zmz-Max/chaowei/README.md

# 超威战队 · CRTC2026

重庆大学机器人训练大赛（CRTC2026）参赛仓库。

| 项目 | 内容 |
| --- | --- |
| 队伍名称 | 超威战队 |
| 组别 | 新生组（队员均为重庆大学 2026 级本科） |
| 参赛机器人 | 1 号车、2 号车（同构） |
| 中期考核截止 | 2026-10-19 24:00（北京时间） |

## 目录结构

```
.
├── docs/              中期考核文档（提交要求：markdown，全部放在根目录 docs/ 下）
│   ├── README.md      文档索引、写作规范与进度看板
│   ├── 01-电气接线.md  供电链路与信号接线（开发记录）
│   └── assets/        文档插图
├── tools/             辅助脚本（生成文档插图等）
└── firmware/          （待建）机器人嵌入式工程
```

## 队伍分工

> 手册要求技术答辩时提供明确的分工名单。

| 角色 | 队员 | 负责内容 |
| --- | --- | --- |
| 队长 | 周孟子 | 电控（嵌入式程序、接线与控制）、组委会沟通、整体进度统筹 |
| 电控 / 硬件 | 王宏博 | 嵌入式程序、接线与控制 |
| 电控 / 硬件 | 吴锐宇 | 嵌入式程序、接线与控制 |
| 机械 | 辛昊 | 结构设计、装配、3D 打印 |
| 机械 | 何佳俊 | 结构设计、装配、3D 打印 |
| 操作手 | 由队员兼任，赛前确定 | 比赛现场操作机器人 |

## 机器人配置

| 部件 | 型号 / 规格 | 数量（单台） |
| --- | --- | --- |
| 主控 | STM32F103C8T6 核心板 | 1 |
| 电机驱动 | DRV8833 红板（丝印 AIN1/AIN2/BIN1/BIN2/STBY，无独立 VCC 引脚） | 2 |
| 动力 | TT 马达 1:48 单轴 | 4 |
| 轮组 | 60mm 黄色麦克纳姆轮 | 4 |
| 底盘 | 四轮金属折弯底盘 | 1 |
| 舵机 | MG995（180°，金属齿）×2、SG90（180°）×4 | 6 |
| 供电 | 18650 双节电池盒（2S 7.4V）+ 无线继电器 | 1 套 |
| 稳压 | Mini DC-DC 降压模块（7.4V → 5V） | 2 |
| 遥控 | PS2 无线手柄（锁定款）+ XTARK TK-PS2A 接收板 | 1 |

## 进度

- [x] 物资采购
- [x] 仓库搭建、文档框架
- [ ] 供电链路焊接与自检
- [ ] 电机驱动接线 + 4 电机转动
- [ ] PS2 手柄控制底盘运动
- [ ] 舵机接线与可动机构
- [ ] 中期考核材料（视频 + 文档 + 规则测评）
