zmz-Max/chaowei/要粘贴的代码.md

# 要粘贴的代码（PS2 手柄遥控底盘）

> 四个步骤：① 新建 `ps2.h` ② 新建 `ps2.c` ③ 在 `main.c` 里粘 5 段 ④ 在 CMakeLists 里加一行。
> 粘完之后可以让 Codex 读一遍你的文件核对，再编译烧录。

---

## 第一步：新建 `Core/Inc/ps2.h`，把下面全部内容粘进去

```c
/**
 * @file    ps2.h
 * @brief   PS2 无线手柄接收板驱动（STM32F103 + HAL 库）
 *
 * 通信协议：同步串行（SPI Mode 3 等效），LSB first，8 位一帧。
 * 硬件连接：CLK → PA5(SPI1_SCK)、CS → PA4(GPIO)、CMD → PA7(SPI1_MOSI)、
 *           DAT → PA6(SPI1_MISO)、VCC → 3.3V、GND → GND
 */

#ifndef PS2_H
#define PS2_H

#include "main.h"

/* 按键位定义（低字节先收到，合成 16 位后与下面位对应） */
#define PSB_SELECT    0x0001
#define PSB_L3        0x0002
#define PSB_R3        0x0004
#define PSB_START     0x0008
#define PSB_UP        0x0010   /* 十字键上 */
#define PSB_RIGHT     0x0020
#define PSB_DOWN      0x0040
#define PSB_LEFT      0x0080
#define PSB_L2        0x0100
#define PSB_R2        0x0200
#define PSB_L1        0x0400
#define PSB_R1        0x0800
#define PSB_TRIANGLE  0x1000   /* 三角 */
#define PSB_CIRCLE    0x2000   /* 圆圈 */
#define PSB_CROSS     0x4000   /* 叉 */
#define PSB_SQUARE    0x8000   /* 方块 */

typedef struct {
    uint8_t  connected;   /* 1 = 本次通信正常 */
    uint8_t  type;        /* 0x41 数字 / 0x73 模拟 / 0x79 双震动 */
    uint8_t  analog;      /* 1 = 已进入模拟模式（能读摇杆） */
    uint16_t btns;        /* 当前按下的所有键（按位或） */
    uint16_t btns_new;    /* 本次新按下的键 */
    uint8_t  lx, ly;      /* 左摇杆 0~255，中位约 128 */
    uint8_t  rx, ry;      /* 右摇杆 0~255，中位约 128 */
} PS2_t;

uint8_t PS2_Init(SPI_HandleTypeDef *hspi, GPIO_TypeDef *cs_port, uint16_t cs_pin);
void    PS2_Read(PS2_t *ps2);

#endif /* PS2_H */
```

---

## 第二步：新建 `Core/Src/ps2.c`，把下面全部内容粘进去

```c
/**
 * @file    ps2.c
 * @brief   PS2 无线手柄接收板驱动实现
 */

#include "ps2.h"

static SPI_HandleTypeDef *s_hspi;
static GPIO_TypeDef      *s_cs_port;
static uint16_t           s_cs_pin;
static uint16_t           s_prev_btns;

#define CS_LOW()   HAL_GPIO_WritePin(s_cs_port, s_cs_pin, GPIO_PIN_RESET)
#define CS_HIGH()  HAL_GPIO_WritePin(s_cs_port, s_cs_pin, GPIO_PIN_SET)

/* 直接读写寄存器收发 1 字节。
   不用 HAL_SPI_TransmitReceive(…, 1)：F1 的 HAL 在单字节收发时存在
   读完 RXNE 前数据未就绪的问题，直接用寄存器最稳。 */
static uint8_t ps2_xfer(uint8_t tx)
{
    uint32_t guard = 100000;

    while (((s_hspi->Instance->SR & SPI_SR_TXE) == 0) && (--guard != 0)) { }
    *(volatile uint8_t *)&s_hspi->Instance->DR = tx;

    guard = 100000;
    while (((s_hspi->Instance->SR & SPI_SR_RXNE) == 0) && (--guard != 0)) { }

    return *(volatile uint8_t *)&s_hspi->Instance->DR;
}

/* 空转延时：-O0 编译下每轮约 8~12 个周期，200 轮约 25us 左右 */
static void ps2_delay_loops(uint32_t n)
{
    for (volatile uint32_t i = 0; i < n; i++) {
        __NOP();
    }
}

/* 一次完整通信：拉低片选 → 逐字节收发 → 拉高片选 → 间隔
 *
 * 时序要点（PS2 协议对时间敏感，太快接收板会来不及应答）：
 * 1. 片选拉低后要等一会儿再发第一个时钟；
 * 2. 字节之间也要留间隔，无线接收板才有时间准备下一字节；
 * 3. 两次通信之间至少间隔 1~2ms。
 */
static void ps2_transact(const uint8_t *tx, uint8_t *rx, uint8_t len)
{
    CS_LOW();
    ps2_delay_loops(200);

    for (uint8_t i = 0; i < len; i++) {
        rx[i] = ps2_xfer(tx[i]);
        ps2_delay_loops(100);
    }

    CS_HIGH();
    ps2_delay_loops(100);
    HAL_Delay(2);
}

/* 判断应答是否有效：收到合法 ID 字节，或收到固定应答字节 0x5A，都算通信正常 */
static uint8_t ps2_reply_valid(const uint8_t *rx)
{
    if (rx[1] == 0x41 || rx[1] == 0x73 || rx[1] == 0x79) {
        return 1;
    }
    if (rx[2] == 0x5A) {
        return 1;
    }
    return 0;
}

uint8_t PS2_Init(SPI_HandleTypeDef *hspi, GPIO_TypeDef *cs_port, uint16_t cs_pin)
{
    uint8_t rx[9];
    GPIO_InitTypeDef gpio = { 0 };

    s_hspi    = hspi;
    s_cs_port = cs_port;
    s_cs_pin  = cs_pin;

    /* 关键：F1 的 HAL_SPI_Init() 只配置外设，不会把 SPI 使能（SPE 仍为 0）。
       本驱动是直接读写寄存器的，必须自己打开 SPI，否则写进 DR 也不会产生
       时钟，读 RXNE 会一直等不到（表现为程序卡死、LED 不闪）。 */
    __HAL_SPI_ENABLE(hspi);

    /* 给 MISO 线（本设计中为 SPI1 的 PA6，接接收板 DAT）打开内部上拉。
       部分 PS2 接收板的 DAT 是开漏输出，没有上拉时永远读不到高电平，
       现象就是"发得出去、收不回来"，LED 一直闪。这一步不需要加电阻。 */
    gpio.Pin  = GPIO_PIN_6;
    gpio.Mode = GPIO_MODE_INPUT;
    gpio.Pull = GPIO_PULLUP;
    HAL_GPIO_Init(GPIOA, &gpio);

    CS_HIGH();
    HAL_Delay(20);

    /* ① 进入配置模式 */
    {
        const uint8_t tx[9] = { 0x01, 0x43, 0x00, 0x01, 0x00, 0x00, 0x00, 0x00, 0x00 };
        ps2_transact(tx, rx, 9);
    }
    /* ② 打开模拟模式 */
    {
        const uint8_t tx[9] = { 0x01, 0x44, 0x00, 0x01, 0x00, 0x00, 0x00, 0x00, 0x00 };
        ps2_transact(tx, rx, 9);
    }
    /* ③ 设置模式：模拟、双摇杆 */
    {
        const uint8_t tx[9] = { 0x01, 0x4F, 0x00, 0xFF, 0xFF, 0x03, 0x00, 0x00, 0x00 };
        ps2_transact(tx, rx, 9);
    }
    /* ④ 退出配置模式 */
    {
        const uint8_t tx[9] = { 0x01, 0x43, 0x00, 0x00, 0x5A, 0x5A, 0x5A, 0x5A, 0x5A };
        ps2_transact(tx, rx, 9);
    }
    /* ⑤ 反复尝试读取：无线接收板第一次应答可能较慢，给它几次机会 */
    s_prev_btns = 0;
    for (uint8_t attempt = 0; attempt < 5; attempt++) {
        const uint8_t tx[9] = { 0x01, 0x42, 0x00, 0x00, 0x00, 0x00, 0x00, 0x00, 0x00 };
        ps2_transact(tx, rx, 9);
        if (ps2_reply_valid(rx)) {
            return 1;
        }
        HAL_Delay(100);
    }
    return 0;
}

void PS2_Read(PS2_t *ps2)
{
    const uint8_t tx[9] = { 0x01, 0x42, 0x00, 0x00, 0x00, 0x00, 0x00, 0x00, 0x00 };
    uint8_t rx[9] = { 0 };

    ps2_transact(tx, rx, 9);

    ps2->type      = rx[1];
    ps2->connected = ps2_reply_valid(rx) ? 1 : 0;
    ps2->analog    = (rx[1] == 0x73 || rx[1] == 0x79) ? 1 : 0;

    if (ps2->connected) {
        uint16_t now  = (uint16_t)(((uint16_t)rx[4] << 8) | rx[3]);
        ps2->btns_new = (uint16_t)(now & (uint16_t)~s_prev_btns);
        ps2->btns     = now;
        s_prev_btns   = now;

        if (ps2->analog) {
            ps2->rx = rx[5];
            ps2->ry = rx[6];
            ps2->lx = rx[7];
            ps2->ly = rx[8];
        }
    } else {
        /* 通信中断：清空状态，避免拿着旧数据继续开车 */
        ps2->btns     = 0;
        ps2->btns_new = 0;
        ps2->analog   = 0;
        s_prev_btns   = 0;
    }
}
```

---

## 第三步：在 `Core/Src/main.c` 里粘 5 段代码

> 每一段都要粘在对应标记行的**下面**（也就是 `USER CODE BEGIN xxx` 和 `USER CODE END xxx` 之间），
> 这样以后 CubeMX 重新生成代码不会把我们的代码冲掉。

### 3-1 粘到 `/* USER CODE BEGIN Includes */` 下面

```c
#include "ps2.h"
```

### 3-2 粘到 `/* USER CODE BEGIN PD */` 下面

```c
#define DUTY_FWD   60      /* 前进 / 后退速度，可改 40~80 */
#define DUTY_TURN  55      /* 原地转向速度 */
```

### 3-3 粘到 `/* USER CODE BEGIN PV */` 下面

```c
static PS2_t ps2;

/* 单个电机：duty -100 ~ +100，负数反转，0 停转 */
static void Motor_Set(uint32_t ch, uint16_t dir_pin, int duty)
{
  const uint32_t arr1 = 50;                 /* ARR(49) + 1 */

  if (duty >  100) duty =  100;
  if (duty < -100) duty = -100;

  if (duty >= 0) {
    HAL_GPIO_WritePin(GPIOB, dir_pin, GPIO_PIN_RESET);   /* 方向脚 = 0 → 正转 */
    __HAL_TIM_SET_COMPARE(&htim2, ch, arr1 * (uint32_t)duty / 100);
  } else {
    HAL_GPIO_WritePin(GPIOB, dir_pin, GPIO_PIN_SET);     /* 方向脚 = 1 → 反转 */
    __HAL_TIM_SET_COMPARE(&htim2, ch, arr1 * (uint32_t)(100 + duty) / 100);
  }
}

/* 底盘：按 左前、左后、右前、右后 四个轮子给速度 */
static void Car_Set(int fl, int rl, int fr, int rr)
{
  Motor_Set(TIM_CHANNEL_1, GPIO_PIN_12, fl);
  Motor_Set(TIM_CHANNEL_2, GPIO_PIN_13, rl);
  Motor_Set(TIM_CHANNEL_3, GPIO_PIN_14, fr);
  Motor_Set(TIM_CHANNEL_4, GPIO_PIN_15, rr);
}
```

### 3-4 粘到 `/* USER CODE BEGIN 2 */` 下面（所有 `MX_xxx_Init()` 之后）

```c
  HAL_TIM_PWM_Start(&htim2, TIM_CHANNEL_1);
  HAL_TIM_PWM_Start(&htim2, TIM_CHANNEL_2);
  HAL_TIM_PWM_Start(&htim2, TIM_CHANNEL_3);
  HAL_TIM_PWM_Start(&htim2, TIM_CHANNEL_4);
  Car_Set(0, 0, 0, 0);

  HAL_GPIO_WritePin(GPIOC, GPIO_PIN_13, GPIO_PIN_SET);   /* 先熄灯，便于区分后面两种状态 */

  if (PS2_Init(&hspi1, GPIOA, GPIO_PIN_4)) {
    HAL_GPIO_WritePin(GPIOC, GPIO_PIN_13, GPIO_PIN_RESET);   /* LED 常亮 = 手柄通信成功 */
  } else {
    /* 通信失败：LED 快闪并停在这里，方便排查接线 */
    while (1) {
      HAL_GPIO_TogglePin(GPIOC, GPIO_PIN_13);
      HAL_Delay(100);
    }
  }

  /* ================= 通道标定（临时调试，查完可删） =================
     上电后自动跑一遍，用来核对“定时器通道 ↔ 实际哪个轮子”的对应关系：
       第 1 段：全部停 3 秒 —— 此时四个轮子必须完全静止；
       第 2~5 段：每段只驱动一个通道（正转 40%），持续 2 秒，
                 该段开始前 LED 会闪 N 下（闪 1 下 = M1，2 下 = M2……）。 */
  Car_Set(0, 0, 0, 0);
  HAL_Delay(3000);

  for (int m = 0; m < 4; m++) {
    Car_Set(0, 0, 0, 0);
    HAL_Delay(300);

    for (int k = 0; k <= m; k++) {
      HAL_GPIO_WritePin(GPIOC, GPIO_PIN_13, GPIO_PIN_RESET);
      HAL_Delay(150);
      HAL_GPIO_WritePin(GPIOC, GPIO_PIN_13, GPIO_PIN_SET);
      HAL_Delay(150);
    }
    HAL_Delay(600);

    switch (m) {
      case 0: Motor_Set(TIM_CHANNEL_1, GPIO_PIN_12, 40); break;
      case 1: Motor_Set(TIM_CHANNEL_2, GPIO_PIN_13, 40); break;
      case 2: Motor_Set(TIM_CHANNEL_3, GPIO_PIN_14, 40); break;
      case 3: Motor_Set(TIM_CHANNEL_4, GPIO_PIN_15, 40); break;
      default: break;
    }
    HAL_Delay(2000);
  }

  Car_Set(0, 0, 0, 0);
  HAL_Delay(1000);
```

### 3-5 粘到 `/* USER CODE BEGIN 3 */` 下面（在 `while (1)` 循环体里）

```c
    PS2_Read(&ps2);

    if (!ps2.connected) {
      Car_Set(0, 0, 0, 0);                                   /* 通信中断立刻停车 */
      HAL_GPIO_WritePin(GPIOC, GPIO_PIN_13, GPIO_PIN_SET);   /* LED 灭 */
    } else {
      HAL_GPIO_WritePin(GPIOC, GPIO_PIN_13, GPIO_PIN_RESET); /* LED 常亮 */

      if (ps2.btns & PSB_UP) {                               /* 十字键上：前进 */
        Car_Set(DUTY_FWD, DUTY_FWD, DUTY_FWD, DUTY_FWD);
      } else if (ps2.btns & PSB_DOWN) {                      /* 十字键下：后退 */
        Car_Set(-DUTY_FWD, -DUTY_FWD, -DUTY_FWD, -DUTY_FWD);
      } else if (ps2.btns & PSB_LEFT) {                      /* 十字键左：原地左转 */
        Car_Set(-DUTY_TURN, -DUTY_TURN, DUTY_TURN, DUTY_TURN);
      } else if (ps2.btns & PSB_RIGHT) {                     /* 十字键右：原地右转 */
        Car_Set(DUTY_TURN, DUTY_TURN, -DUTY_TURN, -DUTY_TURN);
      } else if (ps2.btns & PSB_CROSS) {                     /* 叉键：横移 */
        Car_Set(-DUTY_FWD, DUTY_FWD, DUTY_FWD, -DUTY_FWD);
      } else {
        Car_Set(0, 0, 0, 0);                                 /* 松手即停（滑行） */
      }

      /* 临时调试：按住任意键时熄灭 LED —— 不接电机也能确认按键被读到 */
      if (ps2.btns != 0) {
        HAL_GPIO_WritePin(GPIOC, GPIO_PIN_13, GPIO_PIN_SET);
      }
    }

    HAL_Delay(10);                                           /* 轮询周期约 10ms */
```

---

## 第四步：在 `cmake/stm32cubemx/CMakeLists.txt` 里加一行

找到 `MX_Application_Src` 那个列表里的一行：

```cmake
    ${CMAKE_CURRENT_SOURCE_DIR}/../../Core/Src/main.c
```

在它**下面**加一行：

```cmake
    ${CMAKE_CURRENT_SOURCE_DIR}/../../Core/Src/ps2.c
```

> 不加这一行，编译会报 `undefined reference to 'PS2_Init'`。
> 每次在 CubeMX 里重新生成代码，这个文件都会被重写，**这一行都要重新加一次**。

---

## 粘完之后

告诉 Codex 一声，让他读一遍你的三个文件核对一遍（比人眼快），然后再编译、烧录。
