zmz-Max/chaowei/docs/assets/incident_bare_joint.png

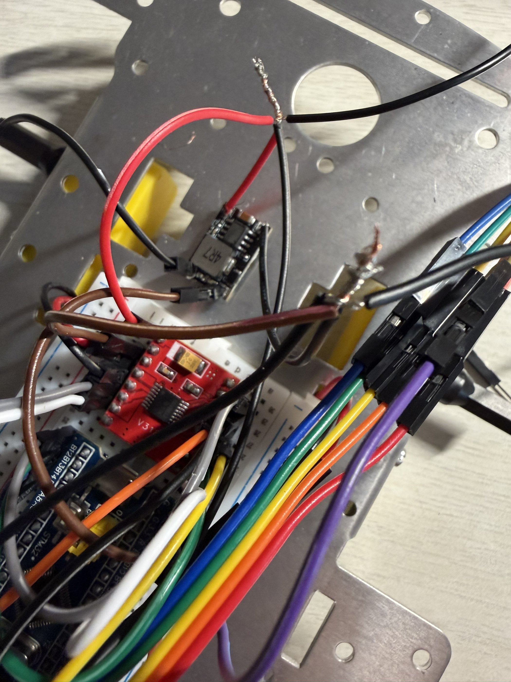
docs/assets/incident_bare_joint.png
