zmz-Max/chaowei/(commit log)

2026-10-12 docs: 建立仓库结构，加入电气接线文档与 DRV8833 实物接线说明
2026-10-12 chore: 忽略本地临时截图文件
2026-10-12 docs: 填写队伍分工名单
2026-10-12 docs: 补充实物接口识别（继电器端子、降压模块、主控）与接线标注图
2026-10-12 docs: 新增电气自检记录表，记录电池盒串联确认结果
2026-10-12 docs: 电源链路自检通过，记录遥控模块点动模式问题
2026-10-13 docs: 补录电源自检实测值，新增 ST-Link 接线与 PS2 接收板实物丝印对应
2026-10-13 docs: 新增定时器与引脚配置表、电机调试步骤
2026-10-13 feat: 新增四路电机测试程序（HAL 与 Arduino 两版）及固件说明
2026-10-13 feat: 新增 PS2 手柄驱动与遥控底盘测试程序，记录降压模块损坏的临时方案
2026-10-14 feat: 集成 PS2 手柄遥控代码到 AIcar 工程并验证编译通过，更新自检记录
2026-10-14 docs: 新增固件工程与调试环境文档，记录 CLion 双配置污染问题
2026-10-14 docs: 记录电源回路短路烧线事故、继电器损坏与整改措施
2026-10-14 docs: 事故照片归档到 assets 并在文档中引用
2026-10-14 docs: 补充短路事故的现场证据与接线工艺整改要求
2026-10-14 chore: 根目录散图不入库，仅保留 docs/assets 下的归档素材
2026-10-14 docs: 新增固件烧录方式与连接失败排查记录（含 flash.cmd）
2026-10-14 feat: 新增一键烧录脚本（根目录 烧录固件.cmd 与 AIcar/flash.cmd）
2026-10-14 fix: 烧录脚本改为 GBK+CRLF 编码，关键命令改为纯 ASCII，实测烧录通过
2026-10-14 docs: 记录 CLion 通过 Embedded GDB Server 烧录成功的流程与输出判读
2026-10-14 fix: PS2 驱动补上 __HAL_SPI_ENABLE 并使等待带超时，修复程序卡死在 RXNE 等待
    [ps2.c]
2026-10-14 docs: 记录 SPI 未使能卡死问题的定位过程与修复，以及 DEV_CONNECT_ERR 的占用原因
2026-10-14 docs: 自检记录更新——固件烧录运行通过（修复 SPI 卡死）
2026-10-14 fix: PS2 驱动给 MISO(DAT) 打开内部上拉，兼容开漏输出的接收板
    [ps2.c]
2026-10-14 docs: 记录锁定款 PS2 手柄必须先锁定配对才能通信（现象与正确操作顺序）
2026-10-14 fix: PS2 时序适配无线接收板（加片选建立/字节间隔），判定放宽为收到合法 ID 也算通
    [ps2.c]
2026-10-14 docs: PS2 手柄通信成功（时序修复），记录无线接收板字节间隔问题
2026-10-15 feat: 增加按键调试反馈（按住任意键时 LED 熄灭），便于不接电机时验证按键
2026-10-15 feat: 增加上电自动通道标定程序，用于核对通道与轮子的对应关系
2026-10-15 chore: 视频不入库（保留在本地磁盘），忽略根目录 mp4
